Picatout/eeprom-programmer/docs/carte-nucleo-branchée.jpg

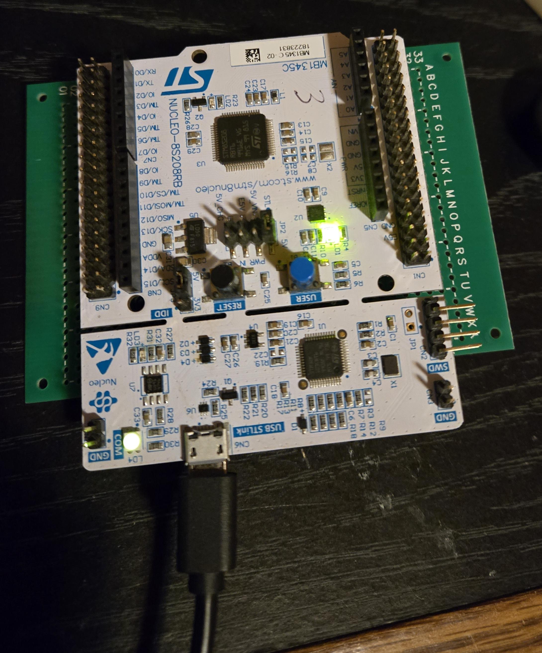
docs/carte-nucleo-branchée.jpg
