Picatout/eeprom-programmer/docs/eprog_ico.png

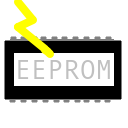
docs/eprog_ico.png
