Picatout/eeprom-programmer/docs/FormPort.png

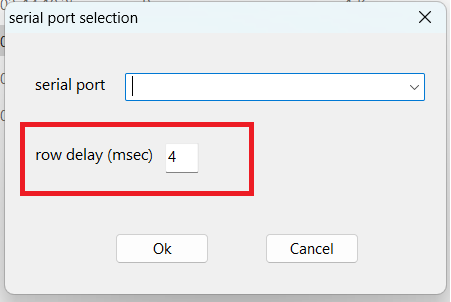
docs/FormPort.png
