Picatout/eeprom-programmer/docs/menuReboot.png

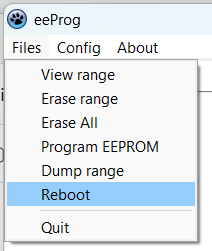
docs/menuReboot.png
