Picatout/eeprom-programmer/journal.md

# notes de travail

### 2026-04-12 

* Corrigé bogue dans [w25q80.asm](w25q80.asm).  **w25q_write_buffer__ n'appelait pas la routine **w25q_wait_eop** pour attendre la fin de l'opération.

### 2026-04-08 
* Le firmware plante lors de la programmation des mémoires FLASH SPI Winbond, W2580 et W25Q128.
    * Bogue résolue, la variable count n'était pas retirée de la pile des retours avant la sortie de la routine w25q_verify.

### 2026-03-29

* Travail sur [w25q80.asm](w25q80.asm).
    * La commande de programmation fonctionne.
* Corrigé bogues dans [w25q80.asm](w25q80.asm). 
    * __w25q_write_buffer__  n'implémentait pas correctement l'incrément et la limite.
* Modifié routine __write_sting__  dans [eeProg.asm](eeProg.asm), n'ajoute plus de zéro à la fin de la chaîne.

### 2026-03-28 

* Débuté travail sur version 3.0 , ajout de la fonctionnalité nécessaire pour programmer les mémoires à interface SPI.
    * lecture de la mémoire W25Q80DV fonctionne.

### 2025-05-22

* GUI_V2.2.2, Correctif à l'application. Lorsque la programmation échouait, la file de réception n'était vidée, ce qui bloquait les autres opérations.

### 2025-05-21 

* GUI_V2.2.1, Correctif à l'application suite à la perte de données lors de la programmation. 

### 2025-05-14

* débogage firwmare, bogue dans la procédure **sst39sf0xx_prog_eeprom**, décrémentait la variable count au lieu de la copie sur la pile.

### 2025-05-13

* Modification du Firmware. 
   * Commande **V** cancellée. Le Firmware contrôle automatiquement l'alimentation de l'EEPROM.
   * Chaque programmation est suivit d'une vérification et envoie d'un code **ACK** en cas de succès ou **NAK** en cas d'échec.
   * Corrigé bogue la routine **at28_prog_eeprom ne tenait pas compte des sauts de page dans la mémoire flash.

### 2025-04-01

* Modification de la schématique. 
	* Ajout d'un switch reset sur la cape.
	* Ajout d'un commutateur 3.3V/5V sur la cape. 
  Ces modifications ont pour but d'un montage dans un boitier et ne change rien à l'utilisation. 

### 2025-03-31

* Modification de l'application. Création des exécutables pour Windows et Ubuntu/Linux. 

### 2025-03-30

* FW_2.0R6  l'ajout d'un délais entre les lignes semble avoir réglé le problème de perte de données.

* Dans la routine **exam_block** ajout d'un délais de 2msec entre chaque ligne.

* Remplacement de **CTRL+R** par **CTRL+X dans le firware du programmeur. FW_V2.0R5

### 2025-03-29

* retour en arrière annulé la commande **!** créée hier dans le firmware.

* Ajoute contrôle de flux **XON|XOFF**. Ajout de la variable **FXOFF=2** dans **flags**.

* Ajout de **CTRL+R** pour redémarrer le programmeur avec un software reset.

### 2025-03-28

* version du firmware FW_2.0.R4
* Modifié le firware pour ajouter la command **!** qui permet de modifier le BAUD rate du port sériel.
    * __n!__   ou n est dans {0..6} ce qui correspond à la table suivante.

| n | baud rate|
|---|---|
0 | 9600
1 | 19200
2 | 38400
3 | 57600
4 | 115200 
5 | 230400
6 | 460800

La valeur d'initialiation et **4** soit **115200** BAUD.

### 2025-03-27 

* Modifié le firmware de la carte NUCLEO pour augmenter la vitesse de communication du port sériel à 460800 BAUD.

* Modifié le firmware de la carte NUCLEO pour ne configurer en sortie seulement les bits d'adresses utilisés par l'EEPROM, i.e. bits 11:0 pour 8K, 13:0 pour 32K, 16:0 pour 128K, 17:0 pour 256K et 18:0 pour 512K. 

### 2025-03-26

* J'avais oublié de décommenté **call clr_screen** au début de la routine **eeProg**.

### 2025-03-25

* Déboguer le firmware V2.0R0 de la carte NUCLEO_8S208RB 

### 2025-03-24

* Travail sur eeProg.asm pour l'adapter à des mémoires de taille supérieure à 64Ko.

* La nouvelle version  

### 2025-03-23

* Travail sur eeProg.asm pour l'adapter à des mémoires de taille supérieure à 64Ko.

### 2025-03-22

* Travail sur eeProg.asm pour l'adapter à des mémoires de taille supérieure à 64Ko.

### 2025-03-21

* Travail sur eeProg.asm pour l'adapter à des mémoires de taille supérieure à 64Ko.

### 2025-03-21

* Création du hardware de la version 2.2 du eeprom-programmer.

### 2025-03-19

* Modification du circuit pour acccomoder les EEPROM fonctionnant à 3.3 volts.

### 2025-02-20

* Agrandir le **tib** à 240 octets. Permet de revecoir des commandes **:** contenant jusqu'à 64 octets ce qui est la taille des pages des EEPROM  AT27Cxxx

### 2025-02-16
* Débuter le projet [eeProg-IDE](eeProg-IDE/eeProg_IDE.lpr), un enviromment graphique pour le programmeur eeProg conçu en free  Pascal en utilisant l'IDE [Lazarus](https://www.lazarus-ide.org/). La version 3.0 est disponible dans les dépôts de Ubuntu 24.04LTS.

* la variable *base* n'était pas initialisée.
* Modifié la routine *print_txt* pour mettre la chaîne ASCII en commentaire. 
* bogue dans XAMBLOCK
```
#0.FFFF
0000: FF    

#
```
Le problème venait de l'instruction **JRMI 2$** qui est utilisé avec les nombre signés. J'ai utilisé à la place l'instruction **JRULT**. Car il s'agit d'une comparaison non signeé entre l'adresse dans **X** et la limite **last**.

### 2025-02-12
* Modifié la routine **readln** dans [terminal.asm](terminal.asm) pour accepter des lignes de 127 caractères. De cette façon on peut programmer jusqu'à 32 octets par ligne au lieu de 16. Le fichier [wozmon.hexdump](wozmon.hexdump) a été modifié pour des lignes de 32 octets de données par ligne.
* **NOTE** le délais interligne a du être augmenté à 20 msec pour que ça fonctionne correctement.
* version 1.0R4
* en mode programmation il est maintenant possible d'ajouter un commentaire à la fin de la ligne après les données. Les commentaires débutent par un point-virgule **;**.
* version 10R5
* Modifié [readme.md](readme.md) pour indiquer qu'il est possible de programmer plusieurs lignes à la suite sans donner d'adresse pour les lignes suivant la première.
* Modifié [wozmon.hexdump](wozmon.hexdump) pour mettre l'instruction RTI à l'adresse $FFF8 et donner cette adresse pour les vecteurs IRQ et NMI.

### 2025-02-11 
* Correction d'un bogue dans routine **print_mem**. 
* version 1.0R1
* Corrigé bogue dans macro **_prog_delay** et dans routine **Timer4UpdateHandler*. 
* version 1.0R2 
* Ajout du fichier [wozmon.hexdump](wozmon.hexdump) au git.
* version 1.0r3

### 2025-02-03
* Création du dépôt sur [github](https://github.com/Picatout/eeprom-programmer).

### 2025-02-02
* Le travail avance sur [eeProg.asm](eeProg.asm).
* Fonction lecture et programmation de l'EEPROM testés et fonctionnels.
* Ajout des commandes 
    * __adr"STRING__  pour programmer une chaîne de caracctère dans l'EEPROM.
    * __adr1Xadr2__  pour effacer un intervalle de mémoire dans l'EEPROM en écrivant la valeur __0xFF__.
#### session 2
* Modifié routine **exam_block** pour afficher les caractères ASCII à la fin de chaque ligne d'octets.

### 2025-02-01
* Assemblage du circuit. 
* Vérification du montage.

### 2025-01-31
* création du projet.
* création de la schématique du programmeur dans KiCAD.
* Le travail avance sur [eeProg.asm](eeProg.asm).
