Picatout/eeprom-programmer/docs/eeprog_v3.0_schematic.pdf

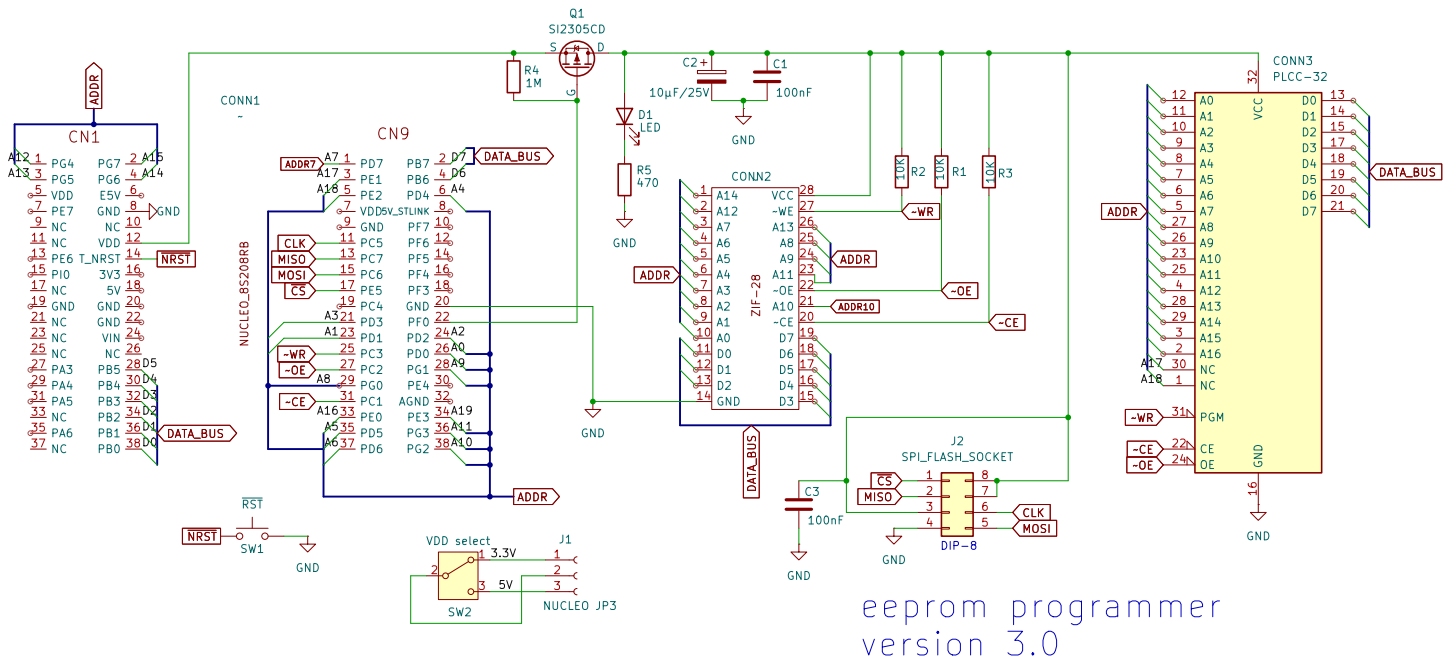
[picture p8: page 1]
