Picatout/eeprom-programmer/docs/EeProg_V2.4_schematic.pdf

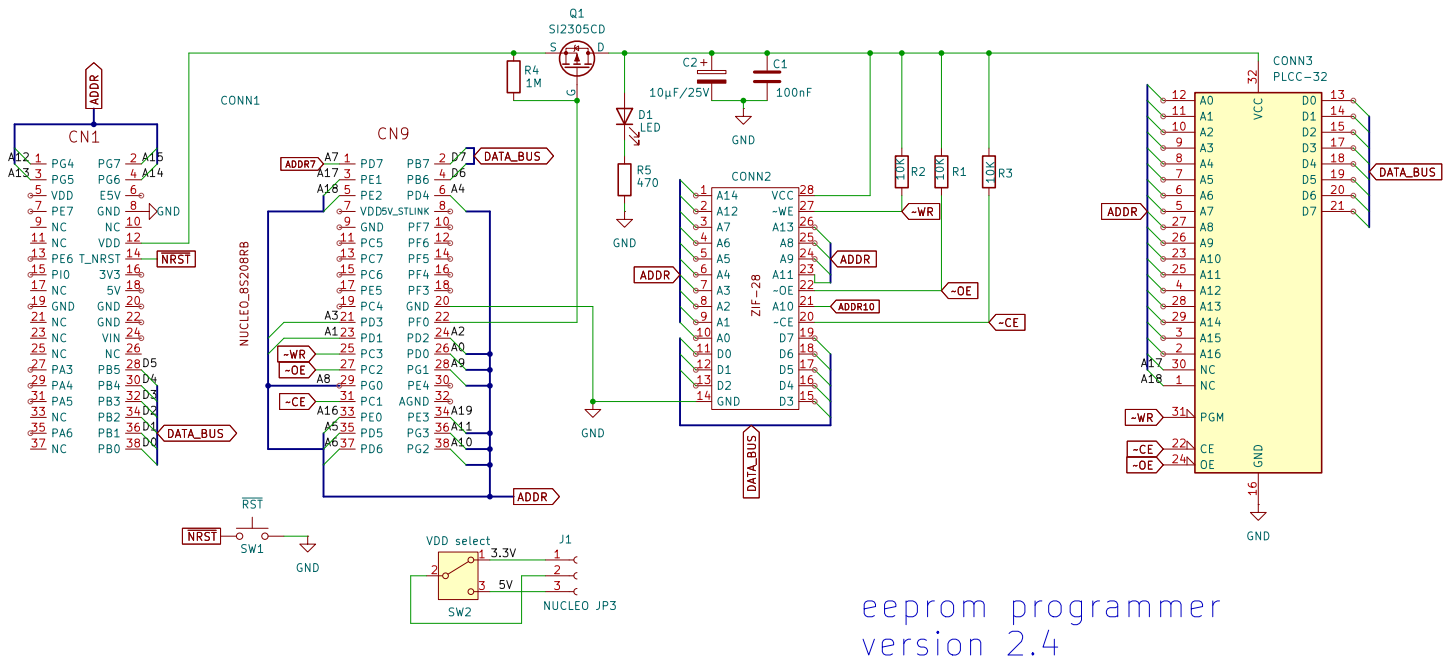
[picture p9: page 1]
