Picatout/eeprom-programmer/(commit log)

2025-01-31 création du git
    [eeprom-programmer.kicad_pcb, eeprom-programmer.kicad_sch]
2025-02-01 le travail avance sur eeProg.asm
    [eeprom-programmer.kicad_sch]
2025-02-02 travail sur le montage
    [eeprom-programmer.kicad_sch]
2025-02-02 continuer le travail sur eeProg.asm maintenant il est possible d'écrire dans l'EEPROM une liste de valeurs hexadécimale ou une chaîne de caractère. il est aussi possible d'effacer un intervalle de mé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
2025-02-03 Ajout de fichiers *.jpg
2025-02-03 ajout de fichiers
2025-02-12 correction dun bogue dans routine print_mem version 1.0R1
    [eeProg.asm]
2025-02-12 Corrigé bogue dans macro _prog_delay et dans routine Timer4UpdateHandler version 1.0R2
    [eeProg.asm, hardware_init.asm]
2025-02-12 Ajout du fichier wozmon.hexdump au git. Ce fichier permet de programmer le Wozmon dans l'EEPROM AT8C64B en utilisant la fonction <send raw file> version v1.0r3
2025-02-12 Modifié readln pour accepter une ligne de 127 caractères au lieu de 79. Ce qui permet de programmer 32 octets par ligne V1.0R4
2025-02-12 V1.0R5 il est maintenant d'ajouter un commentaire en fin de ligne pour le mode progrmmation. Le caractère ; est utilisé pour débuter un commentaire. exemple: 0: 1 2 3 4 5 ; 6 7 8
2025-02-12 Modifié wozmon.hexdump pour mettre une instruction RTI à l'adresse et programmer cette adresse pour les vecteurs IRQ et NMI
2025-02-13 effacer fichier de backups de KiCAD
2025-02-13 Nettoyage de fichiers
2025-02-17 correction d'un bogue dans la routine exam_block qui utilisait JRMI au lieu de JRULT. ajout de caractère commentaire dans le dumping hexadécimal Ajout de CTRL_C pour arrêter un hexdump en cours d'exé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
    [eeProg.asm, terminal.asm]
2025-02-17 Ajout des fichiers journal.md et readme.md au dossier du projet eeProg-IDE
2025-02-19 Modification au système de menus Création du dialogue RANGE développer la fonction du menu view range
2025-02-20 Agrandissement du transaction input buffer à 240 octets ce qui permet de revevoir des lignes de 64 octets en format hexadécimal. C'est le nombre d'octets maximum qui peuvent être programmés dans une 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
2025-02-20 Complété la fonction de programmation à partir d'un fichier binaire
2025-02-21 Généré l'exécutable eeProg_gui sans les informations de déboguage pour réduire la taille
2025-02-21 Correction d'un bogue dans la fonction dump dans un fichier hexadecimal, les 16 premiers octets n'était pas enregistrés dans le fichier. Création d'un vidéo de démonstration sur Youtube
2025-03-02 gui version V1.0R2 Modifié la fenêtre principale pour qu'elle puisse être réduite et déplacée. Modifié certains dialogues
2025-03-02 Version GUI V1.0R3. Modification du dialogue About et du dialogue **Serial port Config** pour que le premier item de la liste soit sélectionné automatiquement.
2025-03-20 modifiation du circuit version 2 de eeprom-programmer
    [eeprom-programmer.kicad_sch]
2025-03-21 Modification au circuit, version 2.1
    [eeprom-programmer.kicad_sch]
2025-03-22 Mofication au circuit du programmeur, version 2.2
    [eeprom-programmer.kicad_sch]
2025-03-26 Version 2.0R0 du firmware de la carte NUCLEO-8S208RB est complété
2025-03-26 FW_V2.0R1 décommenté (call clr_screen) au début de la routine (eeProg).
2025-03-27 Ajouter un lien vers un vidéo de démonstration de la version 2 de l'application dans le readme.md
2025-03-27 FW_V2.0R2 modification de la vitesse du port sérile à 460800BAUD GUI_V2.0R1 Modification du projet Eprog-gui pour s'accordé avec cette nouvelle vitesse de communication
2025-03-27 GUI_V2.0R2 correction d'un bogue dans la procédure ParseLine, provoquait un buffer overrun
2025-03-28 FW_V2.0R3 modification de la configuration des ports E et G pour ne mettre en sortie que les bits requis par l'EEPROM installée sur le programmeur. Ainsi pour les eeprom de 8K seul les bits 3:0 du po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
2025-03-29 Firware version FW_2.0R4 ajout de la commande **n&& make flash* pour permettre la modification du BAUD rate du port sériel. n est une valeur entre 0..6
2025-03-29 FW_V2.0R4 ajout de controle de flux xon/xoff
2025-03-30 travail sur version windows
    travail sur version windows
    problème de communication non résolu
2025-03-30 travail sur version windows
    toujours sur le problème de communicaiton
2025-03-30 travail sur version windows
    Il y a encore des pertes de données envoyé à l'application par le terminal.
2025-03-31 dans la routine exam_block du fichier eeProg.asm ajout d'un délais de 2msec entre chaque row
2025-03-31 travais sur version windows
    toujours le même problème de perte de données en réception
2025-03-31 délais de 2msec insuffisant, test avec 5 msec
2025-03-31 modification dlgPortCfg
    autre tentative de résoudre le problème de perte de données en réception.
2025-03-31 FW_V2.0R6 l'ajout d'un délais semble avoir réglé le problème de perte de données GUI_V2.0R4
2025-03-31 GUI_V2.0R4
    Le problème de perte de donnée semble réglé. Il faut ajuster le délais à 5msec sur windows. Sur Ubuntu aucun délais n'est nécessaire.
2025-03-31 Ajout des exécutable windows et linux dans le dossier eeProg-GUI/dist
2025-03-31 Modifié about
    le boite d'information about va maintenant chercher l'information de version dans l'exécutable.
2025-04-01 modfication mineure au montage de la cape.
    Ajout d'un bouton RESET sur la cape.
    Ajout d'un commteur de sélection VDD 3.3V|5V sur la cape.
    [eeprom-programmer.kicad_sch]
2025-04-25 Version de l'application 2.0.6 correction d'un bogue dans la fonction de programmation d'un fichier binaire.
2025-05-04 Circuit version 2.3 > Modification du circuit pour ajouter un contrôle sur l'alimentation de l'EEPROM ce qui > permet d'installer et d'enlever l'EEPROM du programmeur sans avoir à le débrancher modif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
    [eeprom-programmer.kicad_sch]
2025-05-04 Ajout de documents
2025-05-04 Ajout de la compilation linux
2025-05-07 ersion GUI_V2.1R1 Modifié l'application pour que le dernier fichier utilisé dans les fonctions **Programm EEPROM** et **Dump range** soit conservé pour l'opération suivante.
2025-05-07 Compilation de la version GUI_V2.1R1 pour windows
2025-05-07 GUI_V2.1.1
    compilation de la version windows
2025-05-12 GUI_V2.1.2
    Correction d'un bogue les commande sur la ligne ne fonctionnaient plus car l'alimentation de l'EEPROM n'était pas appliquée.
    application windows recompilée.
2025-05-12 Ajout du binaire pour ubuntu/linux e la version GUI_V2.1.2
2025-05-14 version firmware 2.2r0 correction d'un bogue ajout de vérification de la programmation
    [eeProg.asm, hardware_init.asm, terminal.asm]
2025-05-14 Firmware FW_V2.2R0 débogué. testé sur les 2 types d'eeprom
2025-05-14 GUI_V2.2R0 modifiée pour fonctionner avec la nouvelle version du firmware
2025-05-14 ajout de l'exécutable pour windows
    Ajout de l'exécutable windows pour
    la version GUI_V2.2R0
2025-05-21 GUI_V2.2.1 correction d'un bogue à la réception lors de la programmation des données étaient perdues.
2025-05-21 GUI_V2.2.1 WINDOWS
    Ajout de l'exécutable pour windows de la version GUI_2.2.1
2025-05-23 GUI_V2.2.2, Correctif à l'application. Lorsque la programmation échouait, la file de réception n'était vidée, ce qui bloquait les autres opérations.
2025-05-23 Création de l'exécutable Windows pour la version GUI_V2.2.2
2025-07-15 Modification au circuit électronique. Remplacement du transistor ZTX749 par un P-MOSFET SI2305CD
    [eeprom-programmer.kicad_sch]
2025-07-15 récupération de documents effacés par erreur
2025-07-15 correction d'un oublie dans le dessin du circuit
    [eeprom-programmer.kicad_sch]
2026-03-29 travail sur la version 3 du firmware qui ajoute le support pour la programmation des W25Q80DV
    [eeprom-programmer.kicad_sch]
2026-03-29 la programmation des w25q80dv fonctionne.2
2026-04-08 V3.0R0 corrigé bogue dans routine w25q_veriry
    [w25q80.asm]
2026-04-13 Corrigé bogue dans w25q80.asm la routine w25q_write_buffer n'appelait pas la routine w25q_wait_eop
    [w25q80.asm]
2026-04-13 nouvelle version GUI windows
    mise à jour de l'application pour Windows. Version GUI_V2.3.0
2026-04-13 copie exécutable Windows
    Cope de l'exécutable Windows version 2.3.0 dans le dossier dist
2026-04-13 GUI_2.3R1
    Corrigé bogues
    1) programmation sélectionnait fichier de type hex lorsque l'extension n'était pas .bin maintenant c'est l'inverse tout ce qui n'est pas .hex est considéré comme fichier .bin
    2) la ligne de commande est vidée après l'exécution de la commande.
    3) la réception d'une ligne ne s'interrompt lors de la réception d'un # seulement si c'est le premier caractère de la ligne.
